skrutt/everblink/Capture blink no pullup.PNG

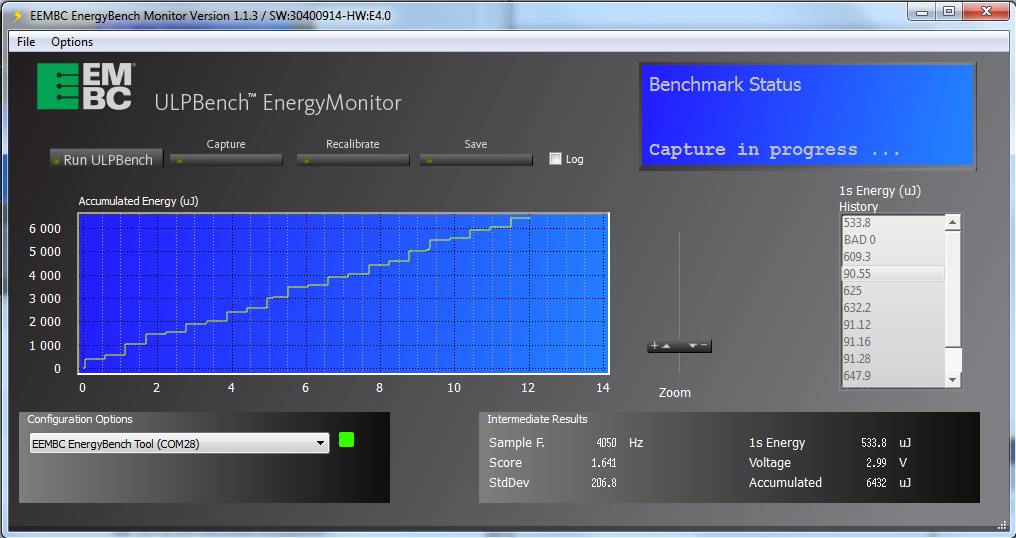
Capture blink no pullup.PNG
