skrutt/everblink/Capture idle.PNG

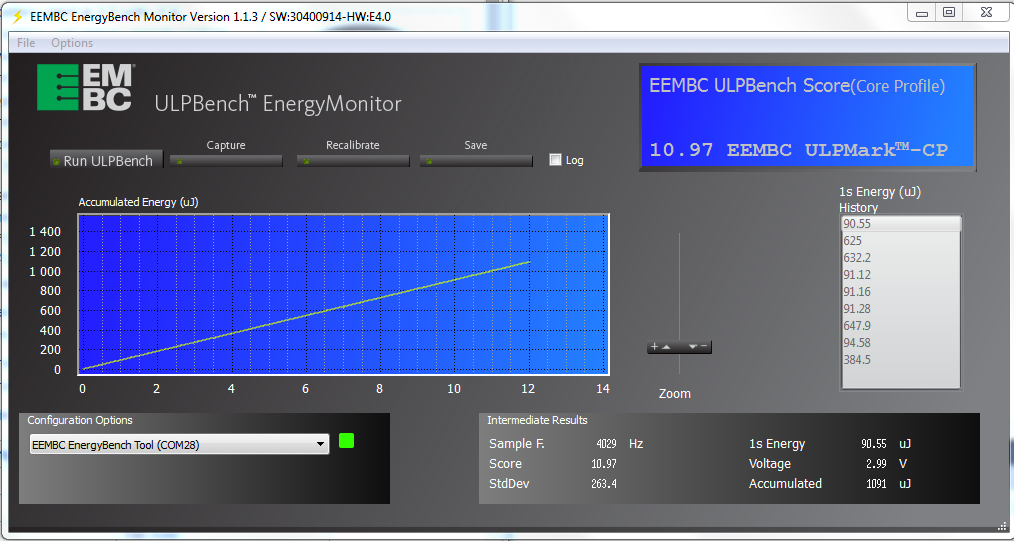
Capture idle.PNG
