skrutt/everblink/shell/rev1.stl

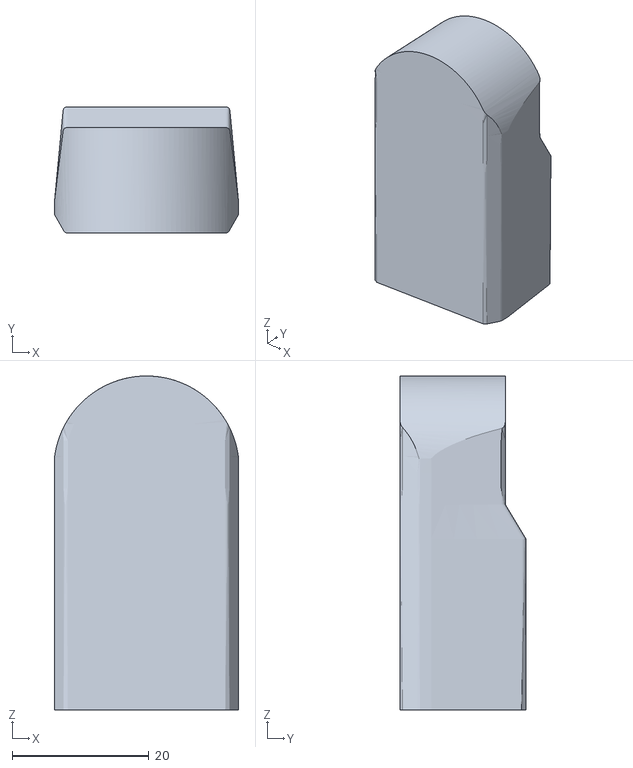
[picture p4: CAD file, 2015-10-04]
shell/rev1.stl
26.9 x 18.4 x 48.8
