skrutt/everblink/(list of files, cad)

Other CAD files:
shell/rev1.3dm
