skrutt/everblink/eagle/rev3.brd

## EAGLE design eagle/rev3.brd (2015-10-03)

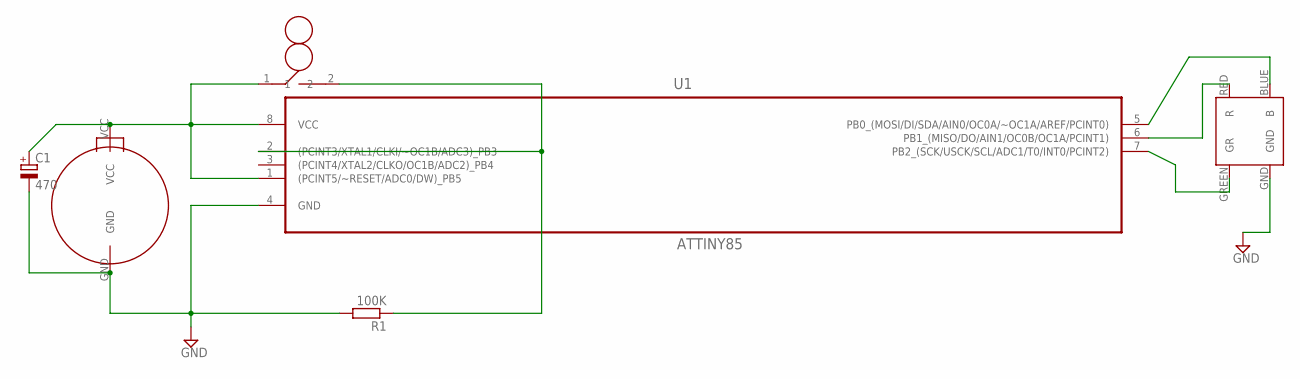
[picture p5: schematic rev3.sch]

Parts:
C1: 470; E2,5-6
R1: 100K; 0207/10
U1: ATTINY85; DIP254P762X533-8; MPN ATTINY85
U$1: CR2032_2PIN
U$2: RGB_4PIN; 5MM_RGB
U$3: BALL_SWITCH; BALL_SW

Connections:
BLUE: U1.7 (PB2_(SCK/USCK/SCL/ADC1/T0/INT0/PCINT2)), U$2.GREEN (GR)
GND: C1.-, R1.2, U1.4 (GND), U$1.GND, U$2.GND
GREEN: U1.6 (PB1_(MISO/DO/AIN1/OC0B/OC1A/PCINT1)), U$2.RED (R)
PB3: R1.1, U1.2 ((PCINT3/XTAL1/CLKI/~OC1B/ADC3)_PB3), U$3.2
RED: U1.5 (PB0_(MOSI/DI/SDA/AIN0/OC0A/~OC1A/AREF/P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), U$2.BLUE (B)
VCC: C1.+, U1.1 ((PCINT5/~RESET/ADC0/DW)_PB5), U1.8 (VCC), U$1.VCC, U$3.1

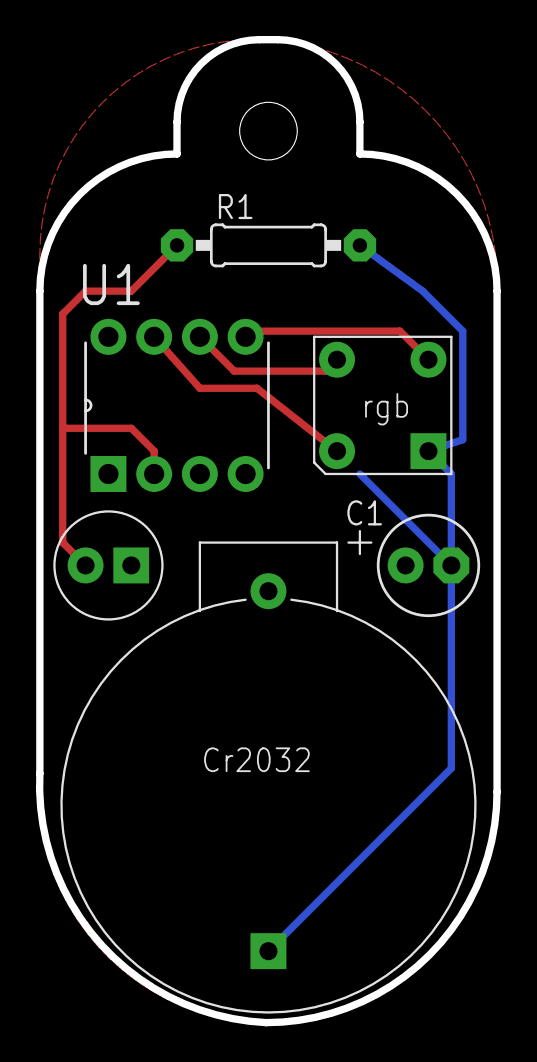
[picture p6: board rev3.brd from above]

Board: 2 copper layers, 25.4 x 54.6 mm, 6 parts (0 on the bottom side), 6 nets.
