skrutt/everblink/eagle/rev2.brd

## EAGLE design eagle/rev2.brd (2015-10-03, an earlier design)

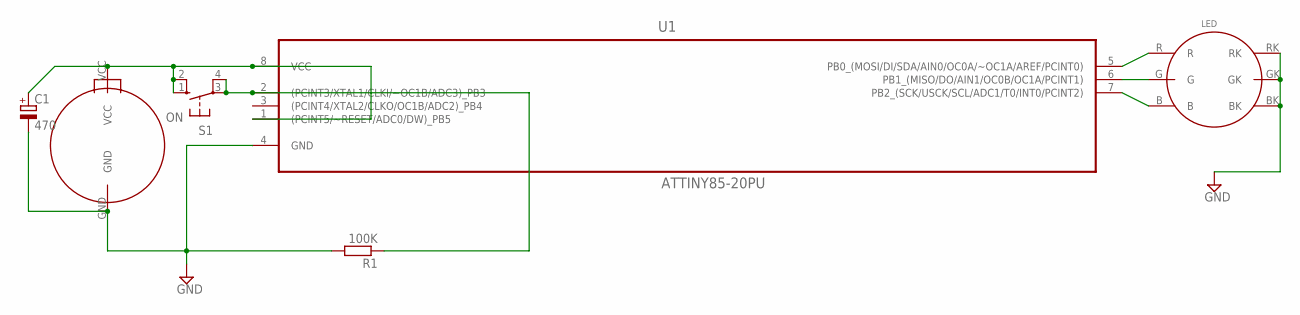
[picture p7: schematic rev2.sch]

Parts:
C1: 470; E2,5-6
LED: 3WLED; 3WRGB
R1: 100K; 0207/10
S1: ON; B3F-10XX
U1: ATTINY85-20PU; DIP254P762X533-8
U$1: CR2032_2PIN

Connections:
BLUE: LED.B, U1.7 (PB2_(SCK/USCK/SCL/ADC1/T0/INT0/PCINT2))
GND: C1.-, LED.BK, LED.GK, LED.RK, R1.2, U1.4 (GND), U$1.GND
GREEN: LED.G, U1.6 (PB1_(MISO/DO/AIN1/OC0B/OC1A/PCINT1))
PB3: R1.1, S1.3, S1.4 (P1), U1.2 ((PCINT3/XTAL1/CLKI/~OC1B/ADC3)_PB3)
RED: LED.R, U1.5 (PB0_(MOSI/DI/SDA/AIN0/OC0A/~OC1A/AREF/P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)
VCC: C1.+, S1.1 (S), S1.2 (S1), U1.1 ((PCINT5/~RESET/ADC0/DW)_PB5), U1.8 (VCC), U$1.VCC

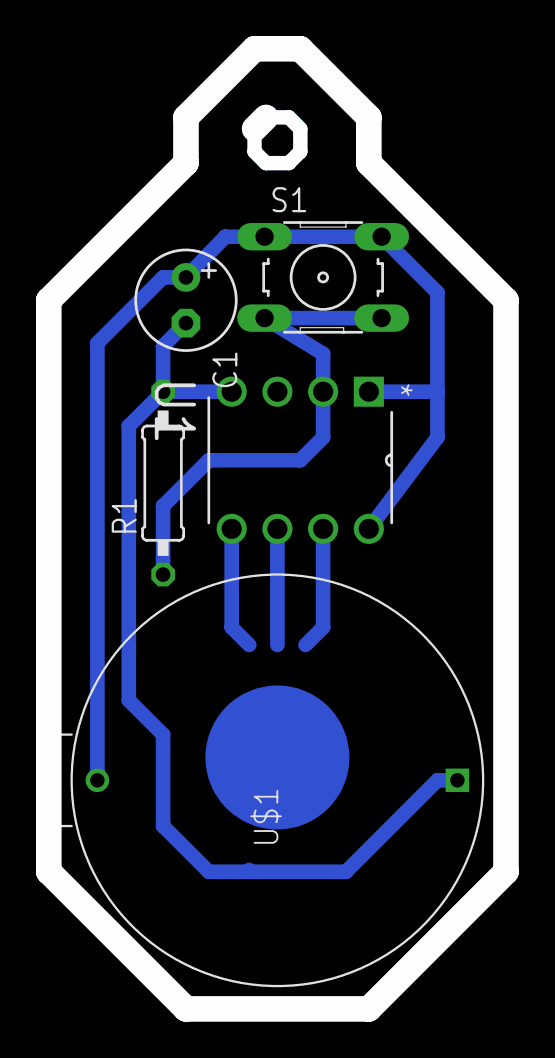
[picture p8: board rev2.brd from above]

Board: 2 copper layers, 25.4 x 53.3 mm, 6 parts (1 on the bottom side), 6 nets.
