skrutt/everblink/(commit log)

2015-10-03 add design files
    first commit
    [board1.brd, rev1.brd, rev1.sch, rev2.brd, rev2.sch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]
2015-10-04 first try at enclosure
    [rev1.3dm, rev1.stl]
2015-10-28 energy analsis
    unit upside down, ie no pullup current
